UlrichMai/MaiPureSpaController/docs/saltwaterpool pcb back and front.jpg

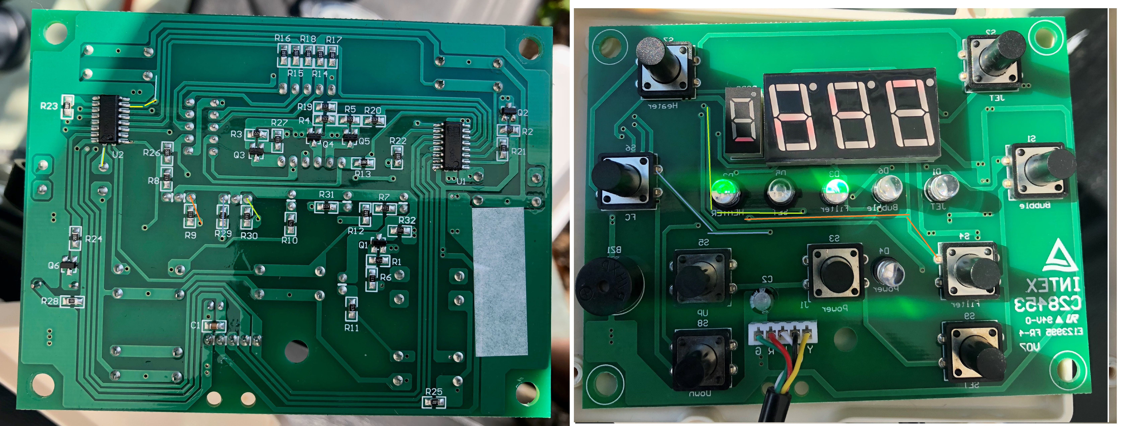
docs/saltwaterpool pcb back and front.jpg
