UlrichMai/MaiPureSpaController/docs/homekit_setup_1.png

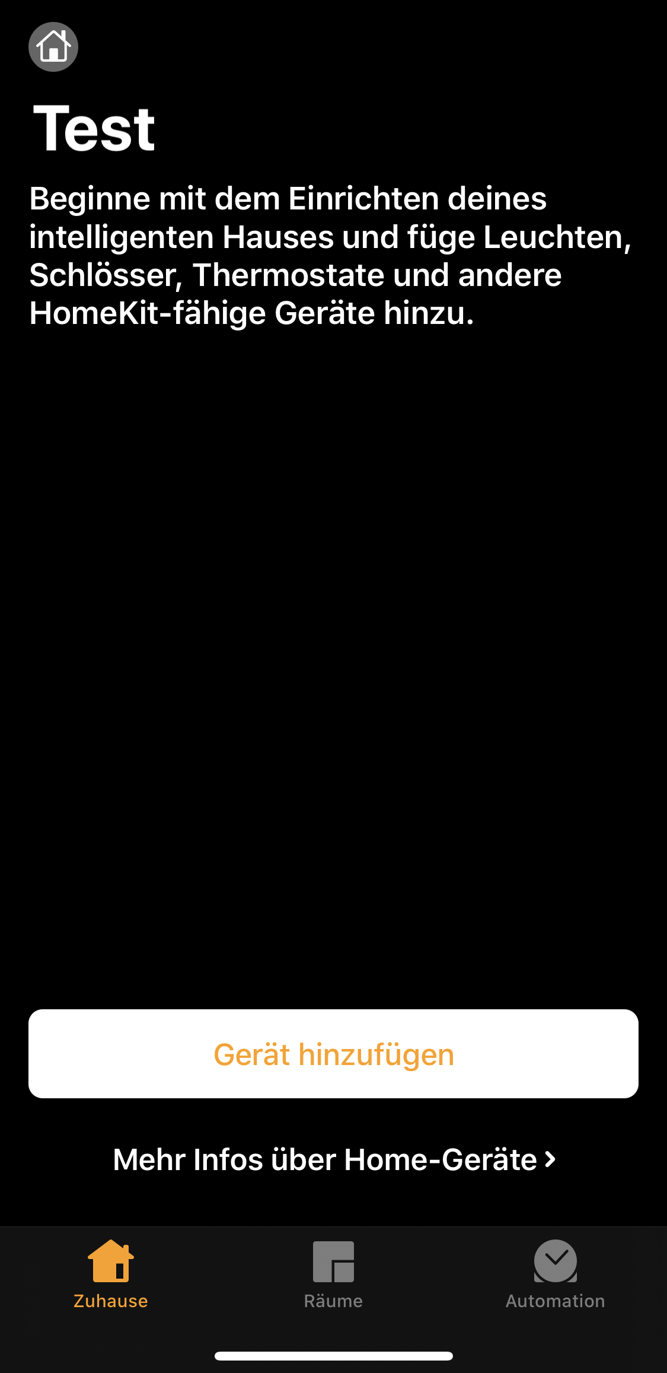
docs/homekit_setup_1.png
