UlrichMai/MaiPureSpaController/docs/homekit_setup_2.png

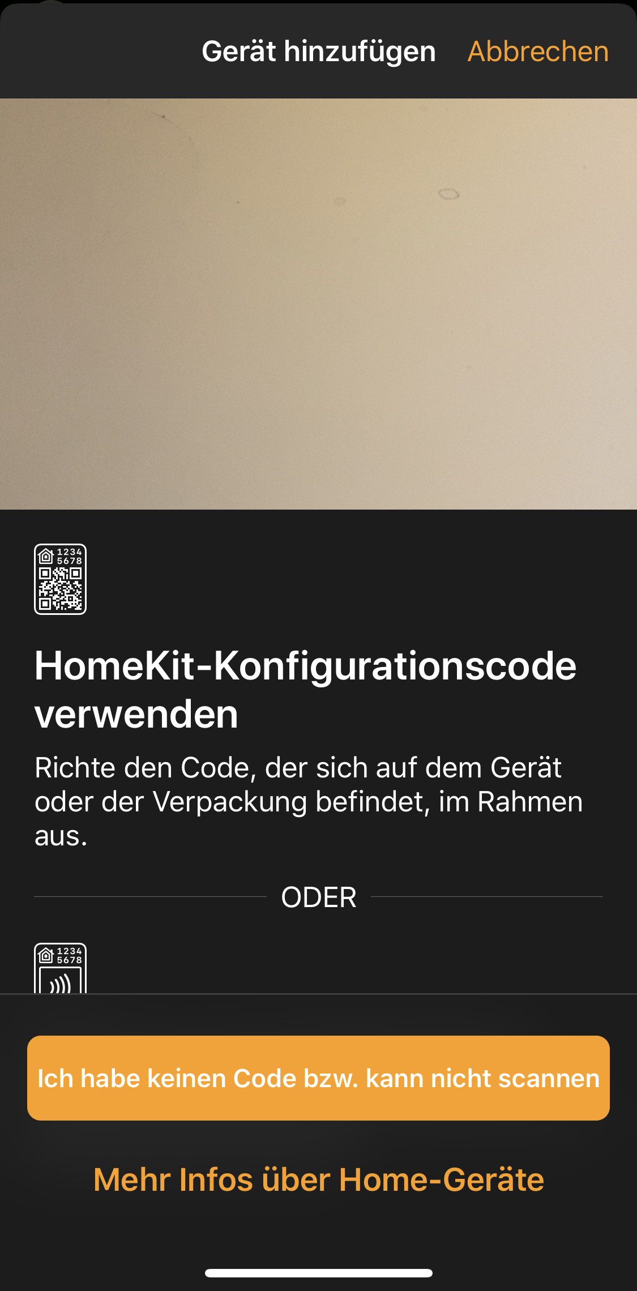
docs/homekit_setup_2.png
