UlrichMai/MaiPureSpaController/docs/homekit_setup_3.png

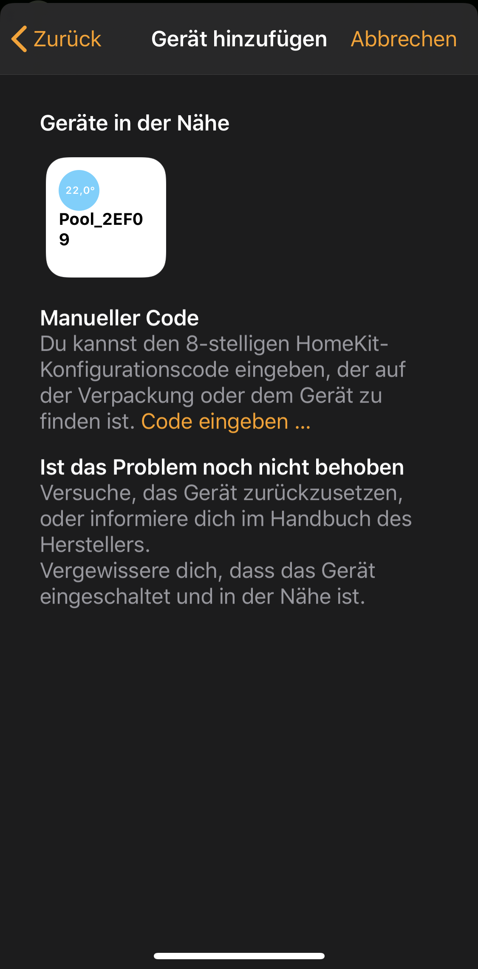
docs/homekit_setup_3.png
