UlrichMai/MaiPureSpaController/docs/homekit_setup_4.png

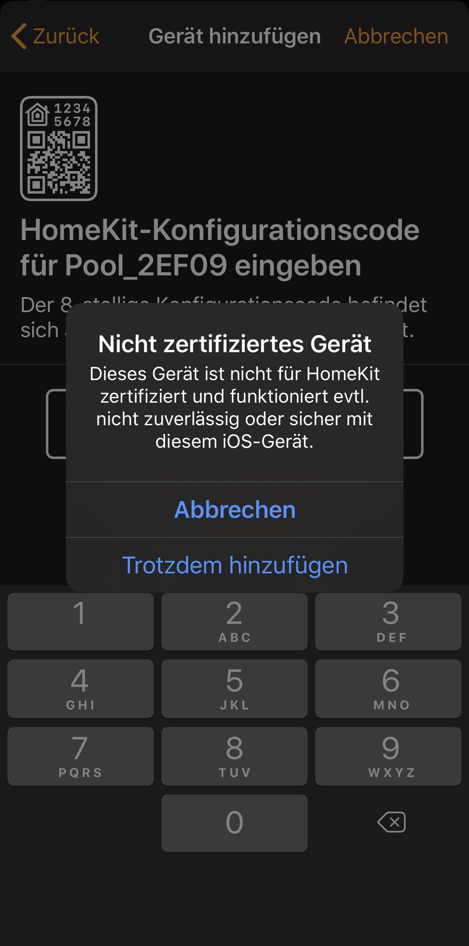
docs/homekit_setup_4.png
