UlrichMai/MaiPureSpaController/docs/homekit_setup_5.png

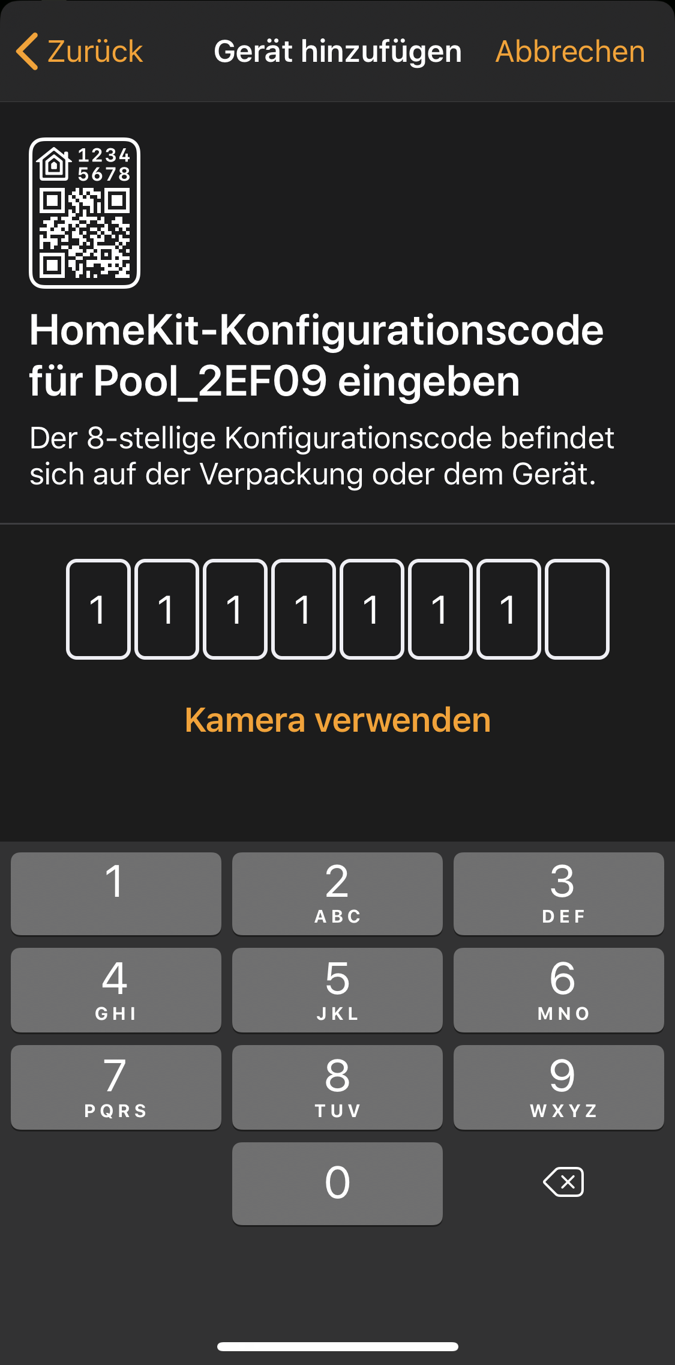
docs/homekit_setup_5.png
