UlrichMai/MaiPureSpaController/docs/homekit_setup_6.png

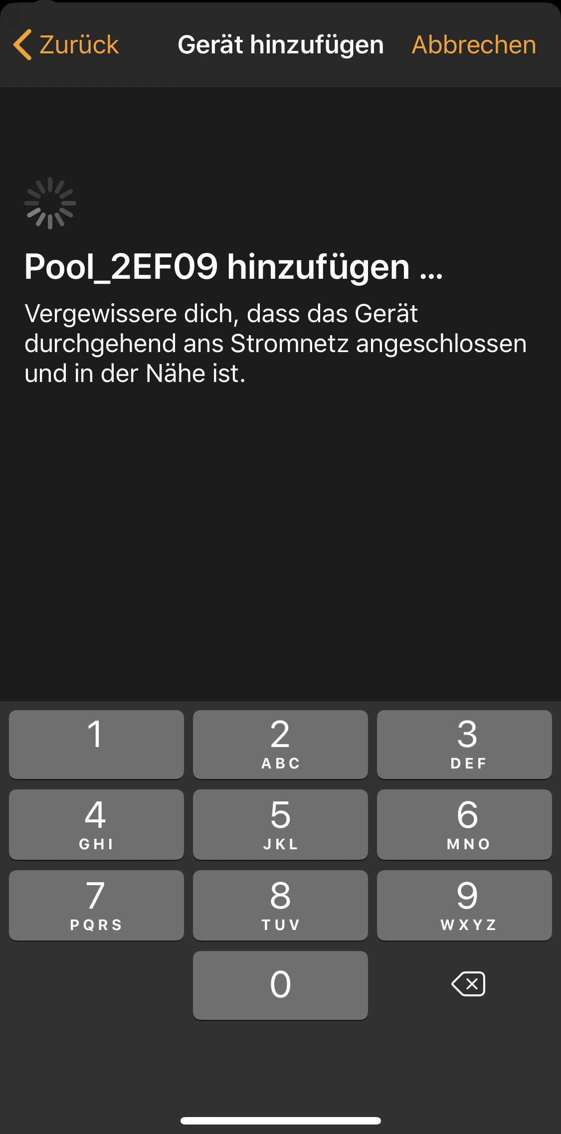
docs/homekit_setup_6.png
