UlrichMai/MaiPureSpaController/docs/homekit_setup_7.png

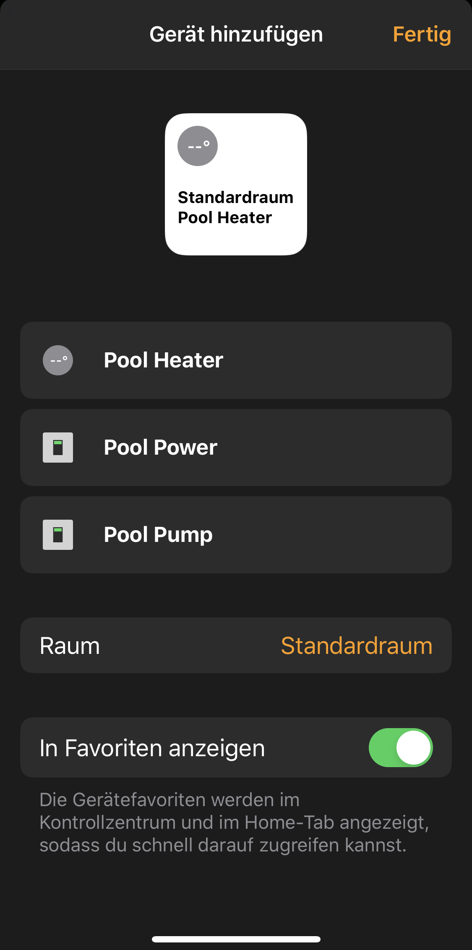
docs/homekit_setup_7.png
