UlrichMai/MaiPureSpaController/docs/homekit_setup_8.png

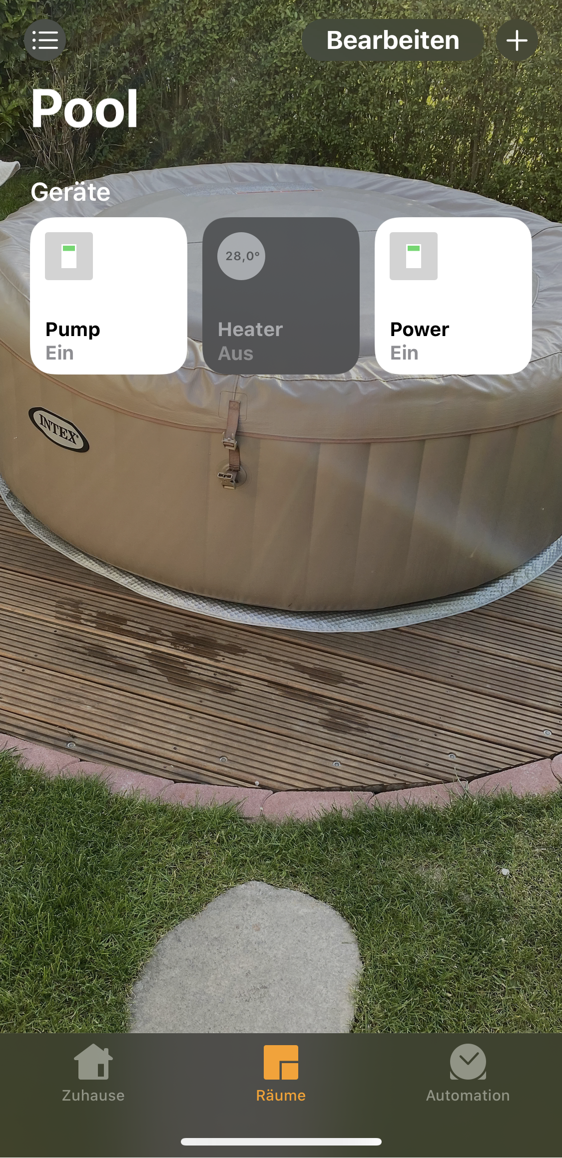
docs/homekit_setup_8.png
