UlrichMai/MaiPureSpaController/docs/homekit_setup_9.png

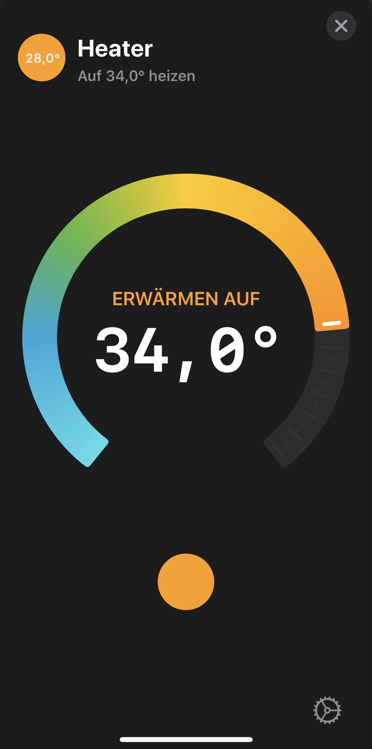
docs/homekit_setup_9.png
