UlrichMai/MaiPureSpaController/(threads)

Thread 1 (2020-06-28):

integration of Saltwater-Spa

red-gee, 2020-06-28:
HI, i have an saltwaterspa from intxxx, for now im experimenting with the code and hardware from Geoffroy (https://github.com/YorffoeG/diyscip), but it would be nice to control it without shift register and demuxer.

The SaltwaterSpa has some buttons extra for Chlorination and Jet
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

maybe it would be a useful....

a mashup between Geoffroy´s version and yours would be great 😉

regards
Gee

UlrichMai, 2020-06-28:
@red-gee, the temperature display and led reading part is working ok? You just need the button coding?
Except for Q1 on U2 looks like my board. The connections on U1 are totally different.
I created a branch [support-saltwaterspa](https://github.com/UlrichMai/diyscip/tree/support-saltwaterspa). Please see that branch for the changes, and let me know if it works.
Can you tell me how the clean button works? It looks like the heater, the led is a red/green one? You press the clean button, the led goes red and after the clean phase it goes green again? Does that led change color over time, telling you must clean?
Do you know the pins, that the clean led is connected to? With this info, we can add a publisher and subscriber for the clean process.
Ulrich

red-gee, 2020-06-28:
@UlrichMai, the clean LED is only green, when you push the cleaning-button, the display shows 003h another push will show you 005h and another 008h. When you push again, your out of menu. When cleaning starts the remaining time will be shown in 00xh in change with the temperature (hope you understand, english not my native language , boarisch liegt ma mehr 😉 )

this is the description and link I've sent Geoffroy :
Maybe another useful information: when I push the Recovery/cleaning Button the 7segment displays shows blinking the cleaning time. First 003H when you push the button again 005H , push again it shows 008H when you wait 10 seconds the blinking stops, and the time to end of recovery would be shown in change with water temperature.

Here is the description in the user manual
https://www.top-poolstore.de/media/Intex-spa/handleiding/spa-bubble-jet-DE.pdf

at the moment its raining cats and dogs and I can't try it, hope it would be better next hours

Gruß
Red-gee

red-gee, 2020-06-29:
Yesterday at 23:10 I connected „PCB v3“ on my spa...... Stable till now!

Only bubble,clean  and power buttons are missing.
When I activate the cleaning, the temperature only shows the time till end, without temperature.
Power, Jet and Filter button are not working.
Themperature heatreached, Heating-Button and heating setting are working fine.

I can send you some states in the evening.

UlrichMai, 2020-06-29:
1.  Are you running the ESP with 160Mhz?
2.  I was not aware, that the display is blinking for the clean time. We need to add some code , so this is not false detected as the desired time. Will do this later. How is your programming skill? Can you propose a change?
Is that blinking faster or slower, than the blinking when you set the desired temperature? Can you point me to video, that shows these 2 blinks or make a video?
3. I am not familiar with your status screen. Do you have a log that shows pub/sub communication over time like this:
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
4. To detect the clean state, we need to know where the clean led is connected. It hat 2 colors. Can you please find out which pin they are connected to?
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

red-gee, 2020-06-29:
Hello,

Here are some answers,
1. Yes I think its running on 160MHz
 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

2. My programming skills are Medium size, but I think it will be no Problem with a little advise from you.

	blinking seems to be the same. Here is the Dropbox-link to the video https://www.dropbox.com/s/foc3gj8ly5j072j/IMG_8578.MOV?dl=0

3. i will hook up my laptop to go to debug mode, then you get a list of the communication.

4. I’ve never seen the LED in other color than green, maybe its integrated, but in the last two years it was not red 😄.
    It is no problem to find out the connection of the LED.

red-gee, 2020-06-29:
hooking up the laptop with debug modus... results  only pressing buttons on original control panel.

hope this helps

[spa_playing_with mqtt.txt](https://github.com/UlrichMai/MaiPureSpaController/files/4847646/spa_playing_with.mqtt.txt)
[clean 3 hours .txt](https://github.com/UlrichMai/MaiPureSpaController/files/4847647/clean.3.hours.txt)
[bubble on.txt](https://github.com/UlrichMai/MaiPureSpaController/files/4847649/bubble.on.txt)
[jet on.txt](https://github.com/UlrichMai/MaiPureSpaController/files/4847650/jet.on.txt)

red-gee, 2020-06-29:
following the path of the clean LED
hope its will be useful
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

UlrichMai, 2020-06-29:
> following the path of the clean LED

I assume
U2-Q7 LED Clean Red = 0x8000
U2-Q5 LED Clean Green = 0x2000
because your `clean 3 hours .txt` is showing `spa/state => 28673`
which is 0x7001 a combination of POWER | FILTER | LED_SELECT | CLEAN_GREEN

UlrichMai, 2020-06-29:
@red-gee, versuch es nochmal. Es waren noch Fehler im Code,  JET konnte noch nicht tun. CLEAN Button sollte jetzt auch ausgelöst werden, aber es fehlt noch Logik um die Stunden auszuwählen. Die Stunden sollten nicht mehr als Temperatur erkannt werden. Die `QTT: subscriber wrong bool value: On` verstehe ich nicht, ist aber mein erster Kontakt mit MQTT. Wenn einige Buttons immer noch nicht funktionieren, dann musst du nochmal die Button Verbindungen zu den Pins von U1/U2 prüfen. Wenn alles nicht hilft, dann müssen wir das Timing mit dem Logic Analysator anschauen. Wenn du keinen Richtigen hast, wie ich, dann ist der für 10€ das richtige, den ich am Ende meines Readme verlinkt habe. Ulrich

red-gee, 2020-06-30:
@UlrichMai, du bist ja fix! Danke, ich werde es gleich noch draufspielen, und tagsüber laufen lassen. Bezüglich logic Tester, ich habe ein smartscope von labnation, das dürfte sicher reichen. Die Mqtt Fehlermeldung sind immer wieder mal da, aber ich habe auch recht wenig Ahnung von Mqtt.

Thank you for your excellent support, I will test it soon

red-gee, 2020-06-30:
@UlrichMai

kurzer Zwischenstand:

Jet : working
clean working

bubble: no switch in iobroker MQTT

UlrichMai, 2020-06-30:
@red-gee, alles andere funktioniert? Super.
Bubble einschalten war im Original nicht vorgesehen. Ist bei meiner HomeKit Version auch nicht drin, weil ich mit dachte das schaltet man an wenn man im Pool sitzt, nicht remote. Ich habe es aber eingebaut. Bitte testen. Ulrich

red-gee, 2020-06-30:
@UlrichMai 👍

perfekt, bisher funktioniert alles.

Jet 👍
Bubble 👍
Power 👍
Heat 👍
Clean 👍
Temp setting 👍
outdoor temperature  👍

was das Bubble und Jet schalten über remote betrifft, ich sehe es als option zum lüften, nach dem Cleaning.

das einzige, das ich noch festgestellt habe, ist das man den Befehl on/off erst nochmal negieren muss und dann nochmal schicken, damit er angenommen wird. Kann aber auch an Iobroker liegen. ich muss das noch mal mit einem anderen MQTT Broker testen.

vielen Dank für den support!

Closed 2020-08-26.

Thread 2 (2020-08-25):

Help needed

jpwcollins, 2020-08-25:
Hi Ulrich

Thank you so much from Canada for creating this amazing device and code! I am using it, but agree it is a bit unstable.

I would like to update to your latest version (the branch on the diyscip project) but I am not at all familiar with coding. I have downloaded VS Code and PlatformIO but am struggling to configure it for upload to my Arduino.

Would you be prepared to help, and if so could I contact you by email?

Thanks so much,

Jonathan

UlrichMai, 2020-08-25:
I am happy to help. You will be the 3rd person I know that is using it, in fact I am meeting a friend tonight to upgrade his pool from MaiPureSpaController to diyscip version.
I think we should keep our discussion in this issue. I might be helpful to other. At least I learn a lot from reading the issues from others. Can you describe what your environment is? Pool version? Windows/Linux? you did build my "pcb less version", meaning putting a D1 mini on the back of the display? You are looking for controlling it via homekit or mqtt or both?

jpwcollins, 2020-08-25:
That’s great, thank you!

Yes, I built your ‘PCB-less version’ using a D1 mini compatible board. I uploaded MaiSpaController to the board using the Arduino IDE application on a Mac.

I’d like to keep using HomeKit, but I can’t figure out how to compile and upload the diyscip code from Github. I’ve opened it with VisualStudio code (with the PlatformIO extension), but when I try to build it I get an error which I think relates to a missing password.ini file. I have chosen the correct (default) options in config.h

Sorry if this is a simple situation. I have no coding experience so I’m learning one step at a time! Thank you for your help!

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

UlrichMai, 2020-08-25:
The password.ini is missing by intention, because it contains passwords, that should never to into git. It contains the password used for over the air updates. I apologize, that I did not provide some sample. I now added a `password.ini.template` file to the repository.
Next problem, that you will run into is, that the homekit library needs some teaks to work in platformio. I also applied some bugfixs and enhancement, that I did not contribute to the original project yet.

I just changed my platform.ini file to point my modified homekit lib version. This should make it easier for you. May be you should delete the `.pio/libdeps` folder to be sure it draws my version.

If you don't have mqtt environment and want to use homekit only, then please comment out the `#define MQTT` in `config.h`

Please use my latest commit and try again.

jpwcollins, 2020-08-26:
Thanks so much for the advice. Following your instructions, I've been able to build and upload your latest commit, and the board connects to my wifi network. Unfortunately I'm having trouble adding the controls to Homekit: the Home app sees the spa, and I can enter the 111-11-111 code, but it fails to add it. I'll keep trying, but would appreciate any further tips!

UlrichMai, 2020-08-26:
This is strange. I had these problem with the old implementation. The pairing with the new version worked for every time. I flashed the new version yesterday evening to a friends pool, and we needed dozens of tries until the pairing worked. I have no clue what causes this trouble.

jpwcollins, 2020-08-26:
Well I'm glad it's not just me! I'll keep trying tomorrow, and let you know how I get on.

Thread 3 (2020-12-15):

Stability improvements

bikemike, 2020-12-15:
Hey, I've got a newer/different model of this SPA (SB-H10) and your method of control seemed the easiest.
Unfortunately the new display can't be taken apart without destroying it (from what I can tell) so I have to put my module in the base unit. I have been copying the core of your code and trying to get it working. I'm not sure if you're still using this or have switched to diyscip but I have found a couple things that will probably fix the stability issues with this code.

The first is ICACHE_RAM_ATTR. You must put this on any function that is called directly or indirectly from an interrupt. Without this, the firmware will crash quite frequently.

Another issue is the size of your btnRequest and btnCount arrays. They are too small by one so probably cause some sort of unwanted issue.

impact27, 2021-01-24:
For reference about `ICACHE_RAM_ATTR`: https://github.com/esp8266/Arduino/blob/master/doc/faq/a02-my-esp-crashes.rst

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

SchneHa, 2021-04-05:
> "It is not very stable, meaning it reboots several times a day. I have not figured out why. Please let me know if you found something that makes it more stable for you."

 => Try to feed the Watchdog Timer:
Insert the following lines:
After "void loop() {":
```
  ESP.wdtFeed();
  ESP.wdtEnable(0);
```
Maybe WDT must also be set to unable
As last line of setup():
`  ESP.wdtDisable();`

Try it out.

SchneHa, 2021-04-05:
> Hey, I've got a newer/different model of this SPA (SB-H10) and your method of control seemed the easiest.
> Unfortunately the new display can't be taken apart without destroying it (from what I can tell) so I have to put my module in the base unit.

I have the same model, can you send a few pictures and describe how you opened it and connected the D1 mini?

bikemike, 2021-04-07:
> I have the same model, can you send a few pictures and describe how you opened it and connected the D1 mini? How did you connect the buzzer?

I will put some instructions and pictures up in the next couple of days. I could not open the display so I opened the base unit and soldered wires to the pins at J5.

My project code is here:

https://github.com/bikemike/IntexSpaManager

Thread 9 (2021-07-15):

Error compil

lolo19430, 2021-07-15:
Hello,
I am trying to compile with Esp8266. And I have error messages ....

Ligne : "void callback(const MQTT::Publish& pub)"

Message : " Not used: C:\Program Files (x86)\Arduino\libraries\pubsubclient
exit status 1
'MQTT' does not name a type"

Thread 12 (2022-07-04):

Missing Bubble Switch in HomeKit

santiagos5, 2022-07-04:
Hello!
First THANKS so much for your jobs!!! I follow your step and all works fine. But I have a question/request.
Why haven’t you add an homekit switch for  bubbles control?
In the web UI, I see that going to url “http://IPspa/bubble” it can turn On/Off the bubbles.
There is a different url for On and Off and an url for current state?
Sorry for the question but I’m not a developer unfortunately..

Thread 13 (2023-08-02):

ESP can read values but writing doesn't work

QBANIN, 2023-08-02:
Hi,
 I've tried to implement your project and everything seems to work (wifi, mqtt, reading values from jacuzzi) but sending buttons events doesn't, no reaction on the jacuzzi panel. The only difference between schematics and my work is that R1 resistor in my case has 977 Ohm (1k 5%). Does it matter?

UlrichMai, 2023-08-02:
The resistor value is ok.
Are you sure, that your esp8266 is running at 160MHz?
This most likely the reason. If it is not running at full speed it misses the time frame to send the key press.

Which implementation are you using?
https://github.com/UlrichMai/MaiPureSpaController is not very stable, and I am not using it anymore.
Did you consider using  https://github.com/UlrichMai/diyscip/tree/support-homekit ?
I ported the code to esphome, because I use homeassistant since 2 years now.

QBANIN, 2023-08-02:
> The resistor value is ok. Are you sure, that your esp8266 is running at 160MHz? This most likely the reason. If it is not running at full speed it misses the time frame to send the key press.
>
> Which implementation are you using? https://github.com/UlrichMai/MaiPureSpaController is not very stable, and I am not using it anymore. Did you consider using https://github.com/UlrichMai/diyscip/tree/support-homekit ? I ported the code to esphome, because I use homeassistant since 2 years now.

I'm using this implementation https://github.com/UlrichMai/MaiPureSpaController flashed over Wemos D1 Mini (not sure what's the cpu speed (?)

QBANIN, 2023-08-02:
BTW. Could you share your ESPhome code?
