UlrichMai/MaiPureSpaController/docs/Intex_Display_PCB_front.jpg

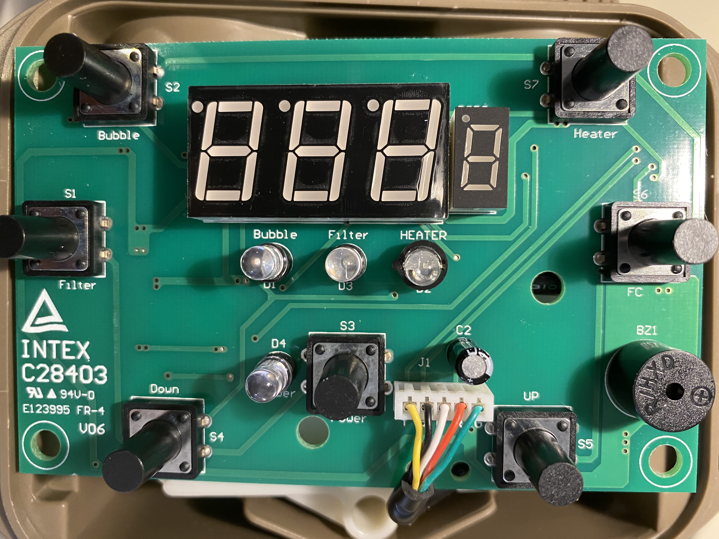
[picture p3: docs/Intex_Display_PCB_front.jpg]
docs/Intex_Display_PCB_front.jpg
